SensorsUnleashed/RadioOne/README.md

# RadioOne
cc2538 based radio board using an XBee footprint.

Rev B.

Ready for prototype fabrication.

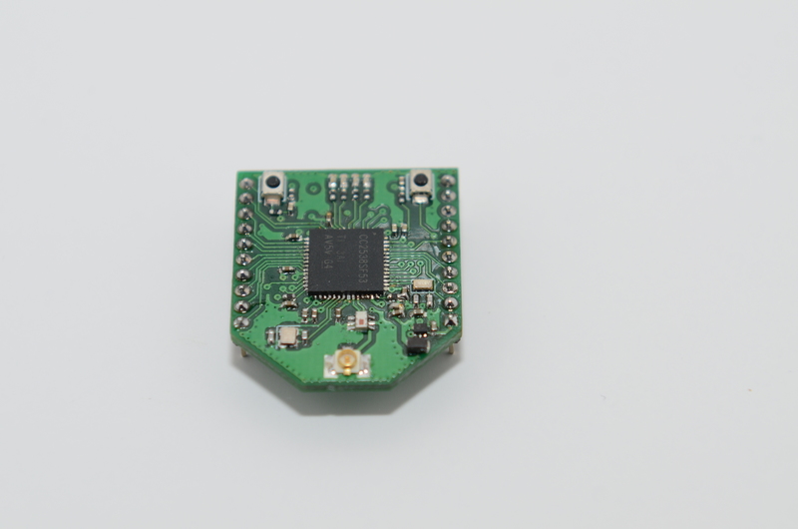
[picture p1: Images/DSC_5430.JPG]
#

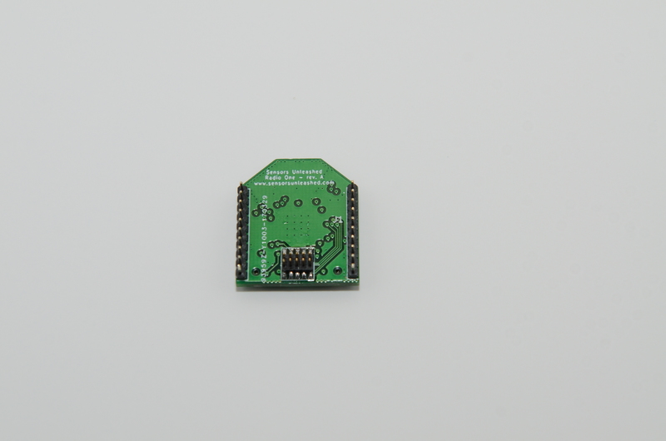
[picture p2: Images/DSC_5437.JPG]
#
