SensorsUnleashed/RadioOne/output/schematic.pdf

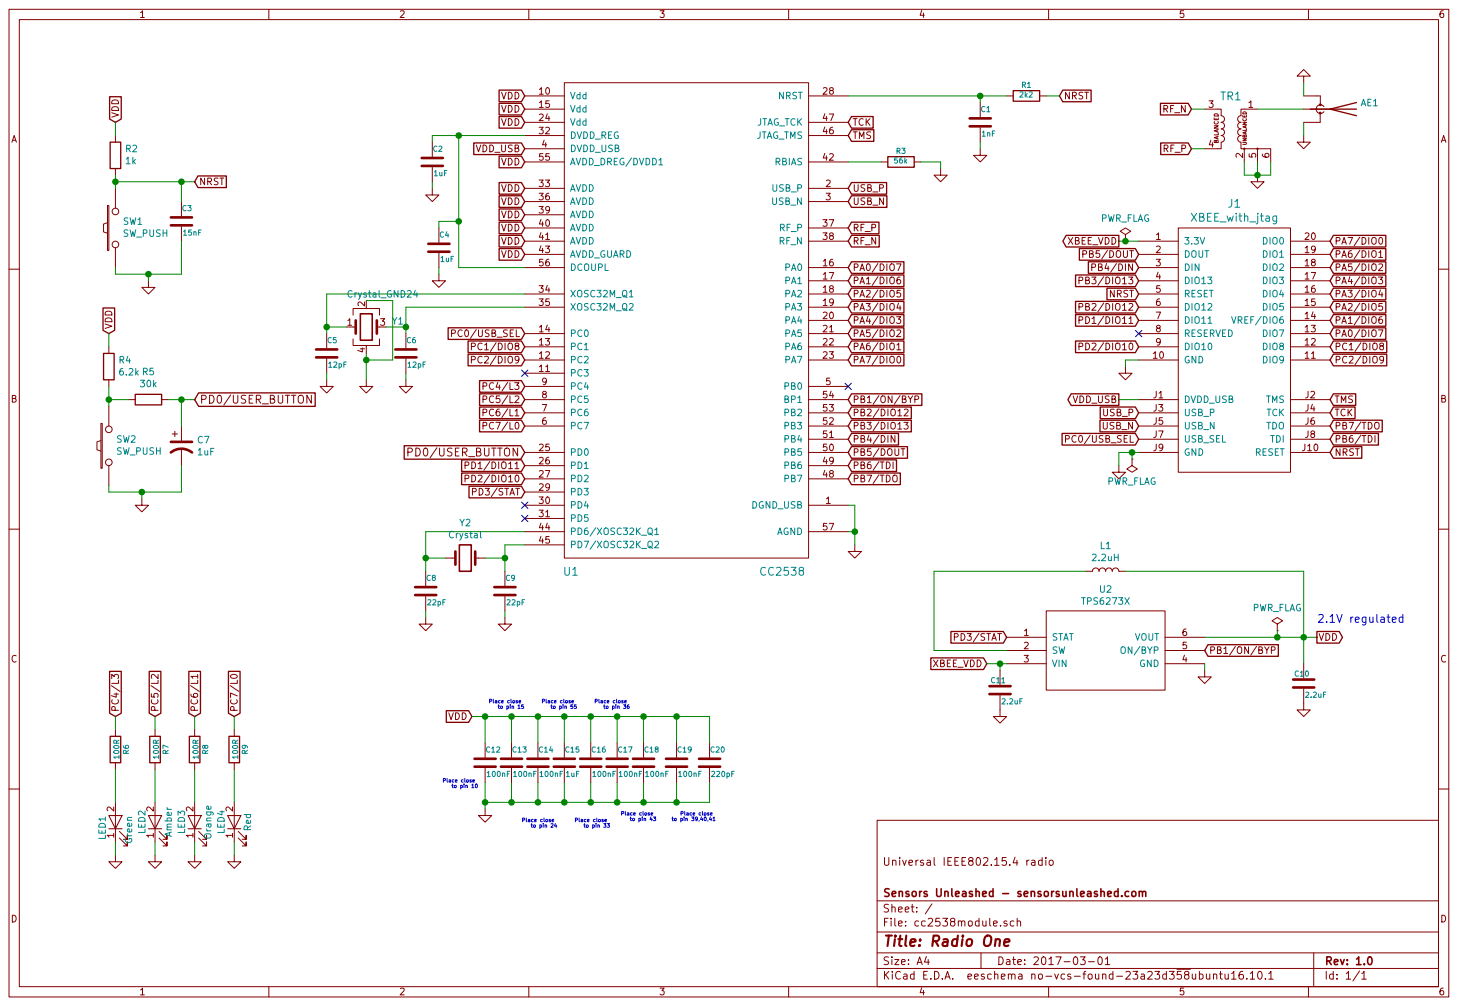
[picture p3: page 1]

1 2 LED1 Green 1 2 LED2 Amber 1 2 LED3 Orange 1 2 LED4 Red PC5/L2 PC6/L1 PC7/L0 R6 100R C12

to pin 15 Place close

to pin 24 Place close
to pin 55 Place close

to pin 39,40,41 Place close
to pin 36Place close

File: cc2538module.sch Sheet: / Sensors Unleashed - sensorsunleashed.com

Id: 1/1 Title: Radio One
