SensorsUnleashed/RadioOne/cc2538module.kicad_pcb

## KiCad design cc2538module.kicad_pcb (2018-10-22)

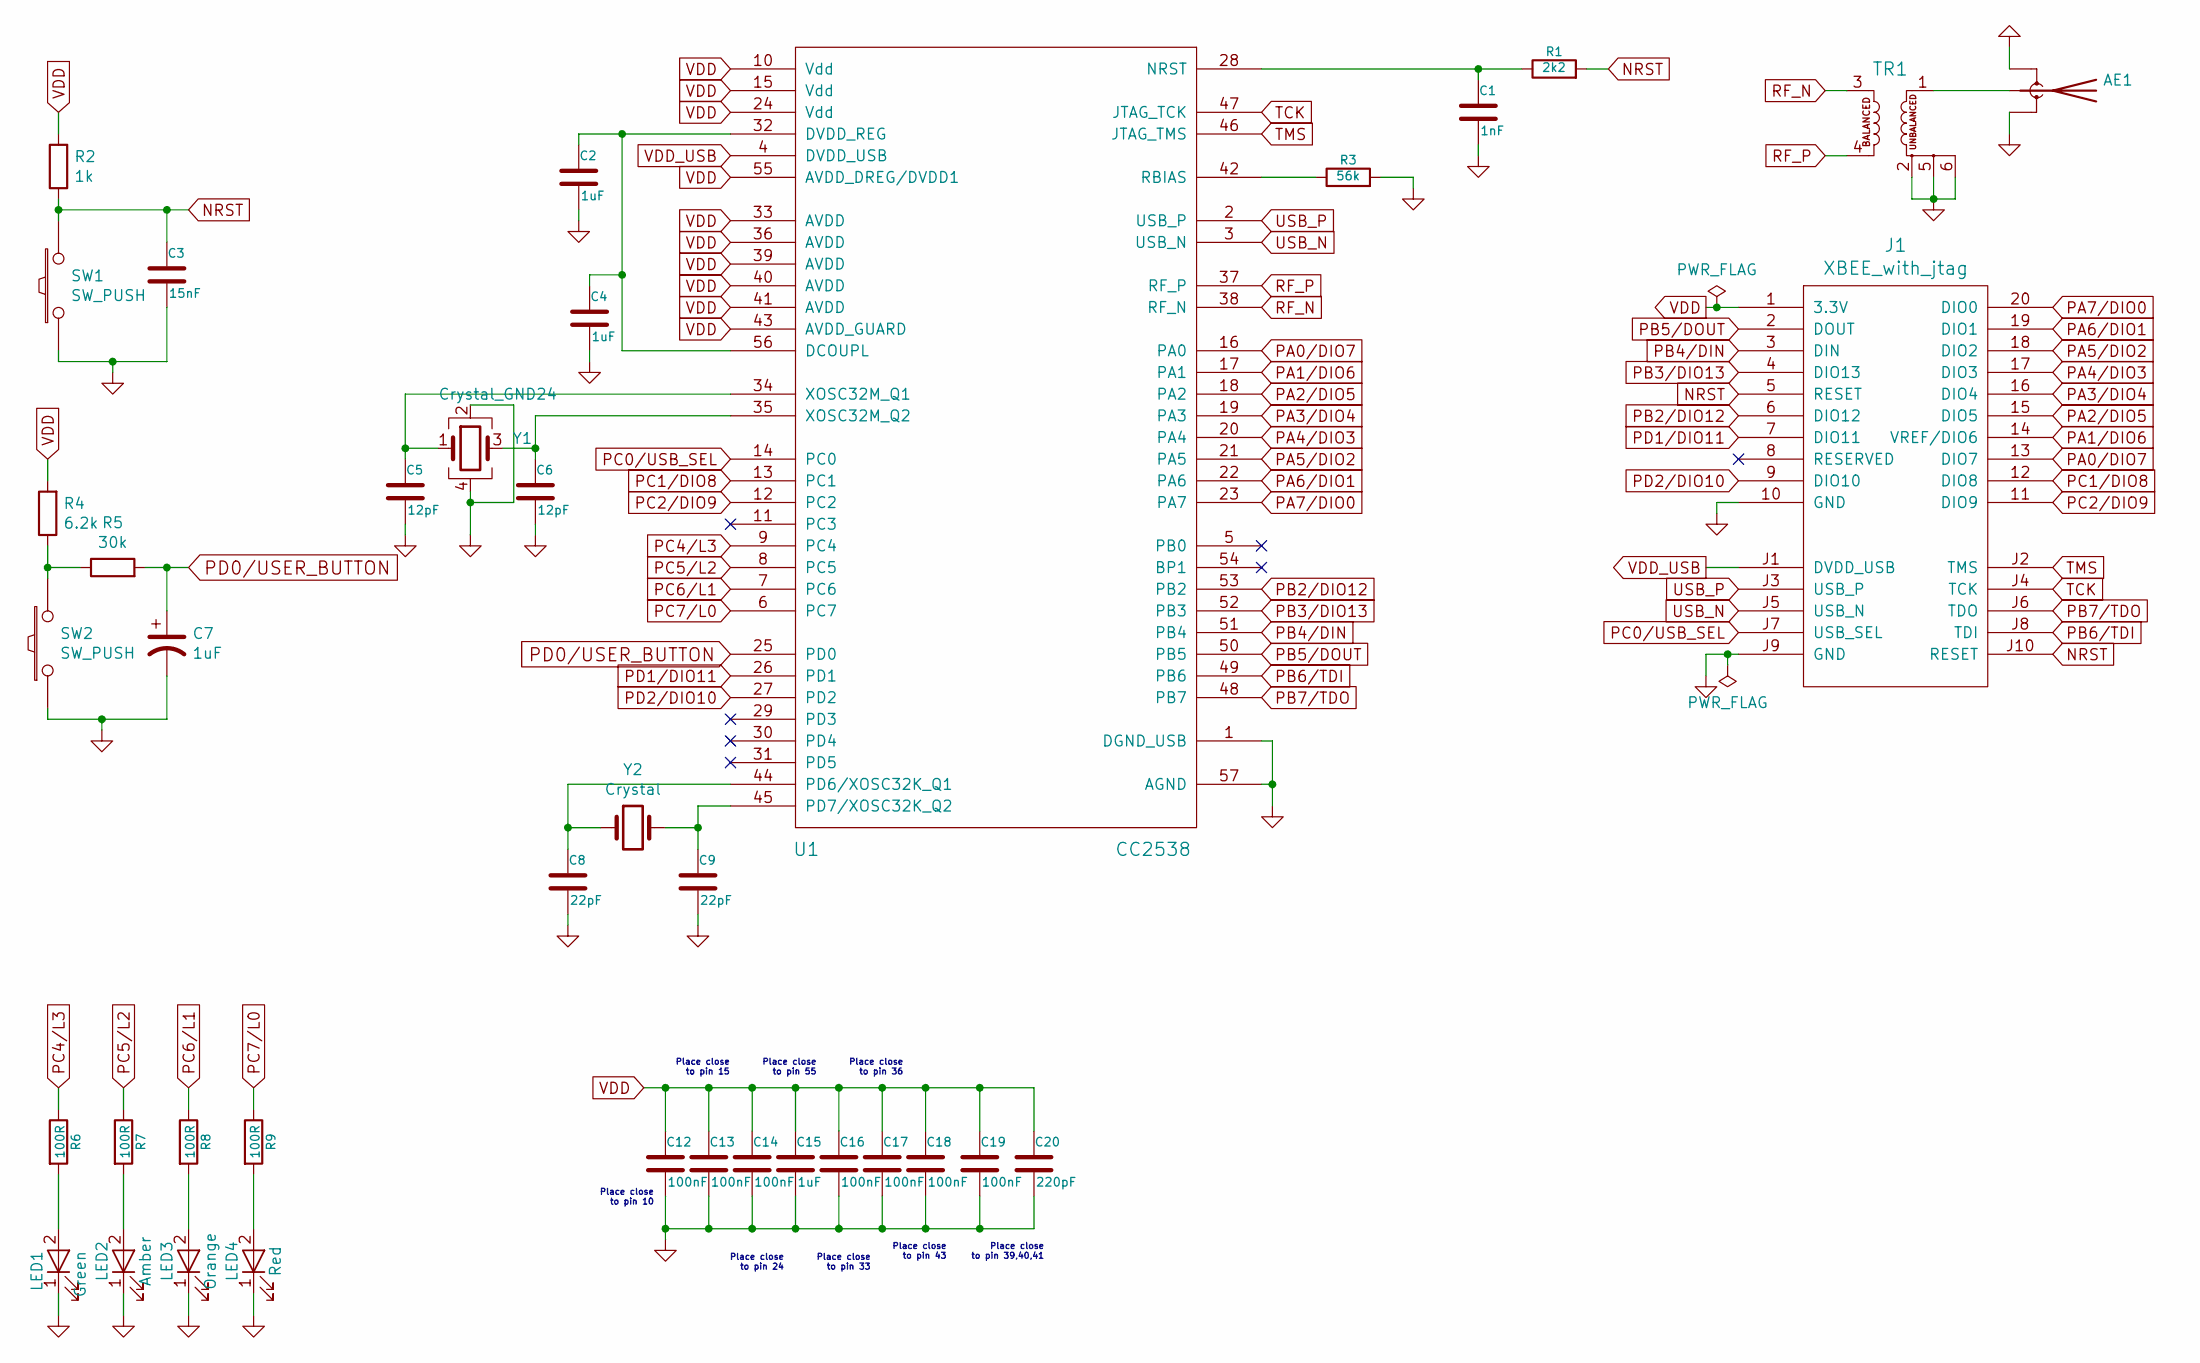
[picture p4: schematic cc2538module.sch, Radio One]

Parts:
AE1: Antenna_Shield_3pin; Antenna_Ext_3pin_smd; Manufacturer Part Number RECE.20279.001E.01
C1: 1nF; C_0402_1005Metric; Manufacturer Part Number GRM155R71H102KA01D
C2, C4, C15: 1uF; C_0402_1005Metric; Manufacturer Part Number GRM155R61A105KE01D
C3: 15nF; C_0402_1005Metric; Manufacturer Part Number GRM155R71H153KA12J
C5, C6: 12pF; C_0402_1005Metric; Manufacturer Part Number GRM1555C1H120JA01D
C7: 1uF; C_0402_1005Metric
C8, C9: 22pF; C_0402_1005Metric; Manufacturer Part Number GRM1555C1H220JA01J
C12, C13, C14, C16, C17, C18, C19: 100nF; C_0402_1005Metric; Manufacturer Part Number GRM155R70J104KA01D
C20: 220pF; C_0402_1005Metric; Manufacturer Part Number GRM1555C1H221JA01D
J1: XBEE_with_jtag; XBEE-HEADER_with_JTAG; Manufacturer Part Number M50-3600542+
LED1: Green; LED_0402_1005Metric; Manufacturer Part Number LNJ347W83RA
LED2: Amber; LED_0402_1005Metric; Manufacturer Part Number LNJ447W84RA1
LED3: Orange; LED_0402_1005Metric; Manufacturer Part Number LNJ847W83RA
LED4: Red; LED_0402_1005Metric; Manufacturer Part Number LNJ247W82RA
R1: 2k2; R_0402_1005Metric; Manufacturer Part Number RC0402FR-072K2L
R2: 1k; R_0402_1005Metric; Manufacturer Part Number RC0402FR-071KL
R3: 56k; R_0402_1005Metric; Manufacturer Part Number RC0402FR-0756KL
R4: 6.2k; R_0402_1005Metric; Manufacturer Part Number RC0402FR-076K2L
R5: 30k; R_0402_1005Metric; Manufacturer Part Number RC0402FR-0730KL
R6, R7, R8, R9: 100R; R_0402_1005Metric; Manufacturer Part Number RC0402FR-07100RL
SW1, SW2: SW_PUSH; SW_SPST_B3U-1000P-B; Manufacturer Part Number B3U-1000P-B
TR1: BALUN_2450BM15A0002; BALUM_2450BM15A0002; Manufacturer Part Number 2450BM15A0002E
U1: CC2538; cc2538_QFN_56; Manufacturer Part Number CC2538NF53RTQR
Y1: Crystal_GND24; Crystal_SMD_2016-4Pin_2.0x1.6mm; Manufacturer Part Number FA-128 32.0000MF20X-K5
Y2: Crystal; Crystal_SMD_2012-2Pin_2.0x1.2mm; Manufacturer Part Number FC-12M 32.7680KA-A5

Connections:
GND: AE1.2 (Shield), C1.2, C2.2, C3.2, C4.2, C5.2, C6.2, C7.2, C8.2, C9.2, C12.2, C13.2, C14.2, C15.2, C16.2, C17.2, C18.2, C19.2, C20.2, J1.10 (GND), J1.J9 (GND), LED1.1 (K), LED2.1 (K), LED3.1 (K), LED4.1 (K), R3.2, SW1.1, SW2.1, TR1.2, TR1.5, TR1.6, U1.1 (DGND_USB), U1.57 (AGND), Y1.2, Y1.4
NRST: C3.1, J1.5 (RESET), J1.J10 (RESET), R1.2, R2.1, SW1.2
unnamed: AE1.1 (A), TR1.1
unnamed: C1.1, R1.1, U1.28 (NRST)
unnamed: C2.1, C4.1, U1.32 (DVDD_REG), U1.56 (DCOUPL)
unnamed: C5.1, U1.34 (XOSC32M_Q1), Y1.1
unnamed: C6.1, U1.35 (XOSC32M_Q2), Y1.3
unnamed: C8.1, U1.44 (PD6/XOSC32K_Q1), Y2.1
unnamed: C9.1, U1.45 (PD7/XOSC32K_Q2), Y2.2
unnamed: LED1.2 (A), R6.2
unnamed: LED2.2 (A), R7.2
unnamed: LED3.2 (A), R8.2
unnamed: LED4.2 (A), R9.2
unnamed: R3.1, U1.42 (RBIAS)
unnamed: R4.1, R5.1, SW2.2
PA0/DIO7: J1.13 (DIO7), U1.16 (PA0)
PA1/DIO6: J1.14 (VREF/DIO6), U1.17 (PA1)
PA2/DIO5: J1.15 (DIO5), U1.18 (PA2)
PA3/DIO4: J1.16 (DIO4), U1.19 (PA3)
PA4/DIO3: J1.17 (DIO3), U1.20 (PA4)
PA5/DIO2: J1.18 (DIO2), U1.21 (PA5)
PA6/DIO1: J1.19 (DIO1), U1.22 (PA6)
PA7/DIO0: J1.20 (DIO0), U1.23 (PA7)
PB2/DIO12: J1.6 (DIO12), U1.53 (PB2)
PB3/DIO13: J1.4 (DIO13), U1.52 (PB3)
PB4/DIN: J1.3 (DIN), U1.51 (PB4)
PB5/DOUT: J1.2 (DOUT), U1.50 (PB5)
PB6/TDI: J1.J8 (TDI), U1.49 (PB6)
PB7/TDO: J1.J6 (TDO), U1.48 (PB7)
PC0/USB_SEL: J1.J7 (USB_SEL), U1.14 (PC0)
PC1/DIO8: J1.12 (DIO8), U1.13 (PC1)
PC2/DIO9: J1.11 (DIO9), U1.12 (PC2)
PC4/L3: R6.1, U1.9 (PC4)
PC5/L2: R7.1, U1.8 (PC5)
PC6/L1: R8.1, U1.7 (PC6)
PC7/L0: R9.1, U1.6 (PC7)
PD0/USER_BUTTON: C7.1, R5.2, U1.25 (PD0)
PD1/DIO11: J1.7 (DIO11), U1.26 (PD1)
PD2/DIO10: J1.9 (DIO10), U1.27 (PD2)
RF_N: TR1.3, U1.38 (RF_N)
RF_P: TR1.4, U1.37 (RF_P)
TCK: J1.J4 (TCK), U1.47 (JTAG_TCK)
TMS: J1.J2 (TMS), U1.46 (JTAG_TMS)
USB_N: J1.J5 (USB_N), U1.3 (USB_N)
USB_P: J1.J3 (USB_P), U1.2 (USB_P)
VDD: C12.1, C13.1, C14.1, C15.1, C16.1, C17.1, C18.1, C19.1, C20.1, J1.1 (3.3V), R2.2, R4.2, U1.10 (Vdd), U1.15 (Vdd), U1.24 (Vdd), U1.33 (AVDD), U1.36 (AVDD), U1.39 (AVDD), U1.40 (AVDD), U1.41 (AVDD), U1.43 (AVDD_GUARD), U1.55 (AVDD_DREG/DVDD1)
VDD_USB: J1.J1 (DVDD_USB), U1.4 (DVDD_USB)

Notes on the sheet:
Place close to pin 10
Place close to pin 15
Place close to pin 24
Place close to pin 55
Place close to pin 33
Place close to pin 39,40,41
Place close to pin 36
Place close to pin 43

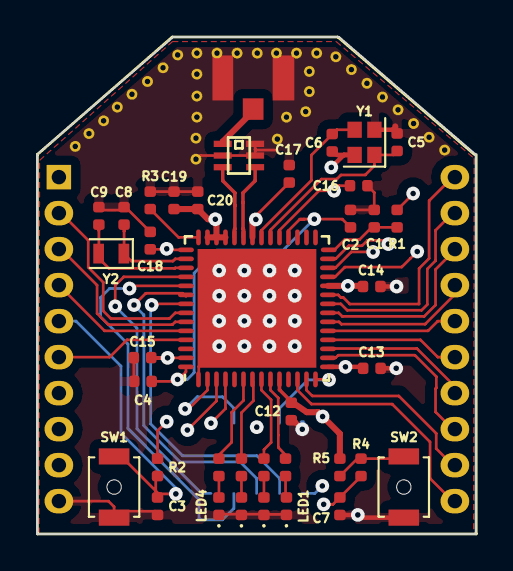
[picture p5: board cc2538module.kicad_pcb from above]

Board: 4 copper layers, 24.4 x 27.6 mm, 39 parts (0 on the bottom side), 47 nets.
