SensorsUnleashed/RadioOne/(commit log)

2017-03-06 Board rev.1 finished and send to DirtyPCB for prototyping
    [cc2538module.kicad_pcb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]
2017-03-12 Updated component infos
    [cc2538module.sch]
2017-03-14 Changed the header description
    [bom.csv, cc2538module.sch]
2017-03-19 Added C5 to PCB and rearrange the step down power converter as described in its datasheet
    [cc2538module.kicad_pcb]
2017-03-29 New footprint and various small changes. PCB ordered at DirtyPCB 20170328
    [cc2538module.kicad_pcb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]
2017-04-18 Print has arrived, images added
2018-10-22 Rev B
    [cc2538module.kicad_pcb, cc2538module.sch]
2018-10-22 Made paths relavtive to the project dir
    [cc2538module.sch]
2018-10-22 Removed old files not valid for rev B
    [cc2538module-B.Cu.gbl, cc2538module-B.Mask.gbs, cc2538module-B.SilkS.gbo, cc2538module-F.Cu.gtl, cc2538module-F.Mask.gts, cc2538module-F.SilkS.gto, cc2538module.drl]
